bfbachmann/Terminator-2.0/progress_report/sensors_bb.png

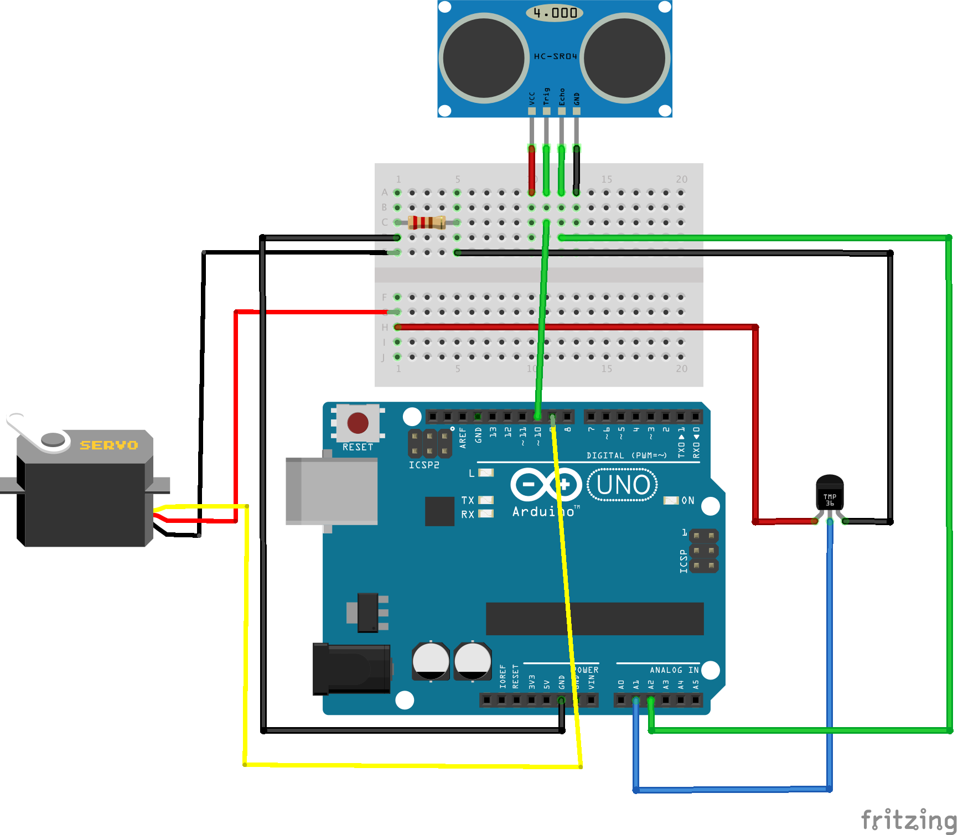
progress_report/sensors_bb.png
