bfbachmann/Terminator-2.0/report/project-1-report/line_following_block_diagram.pdf

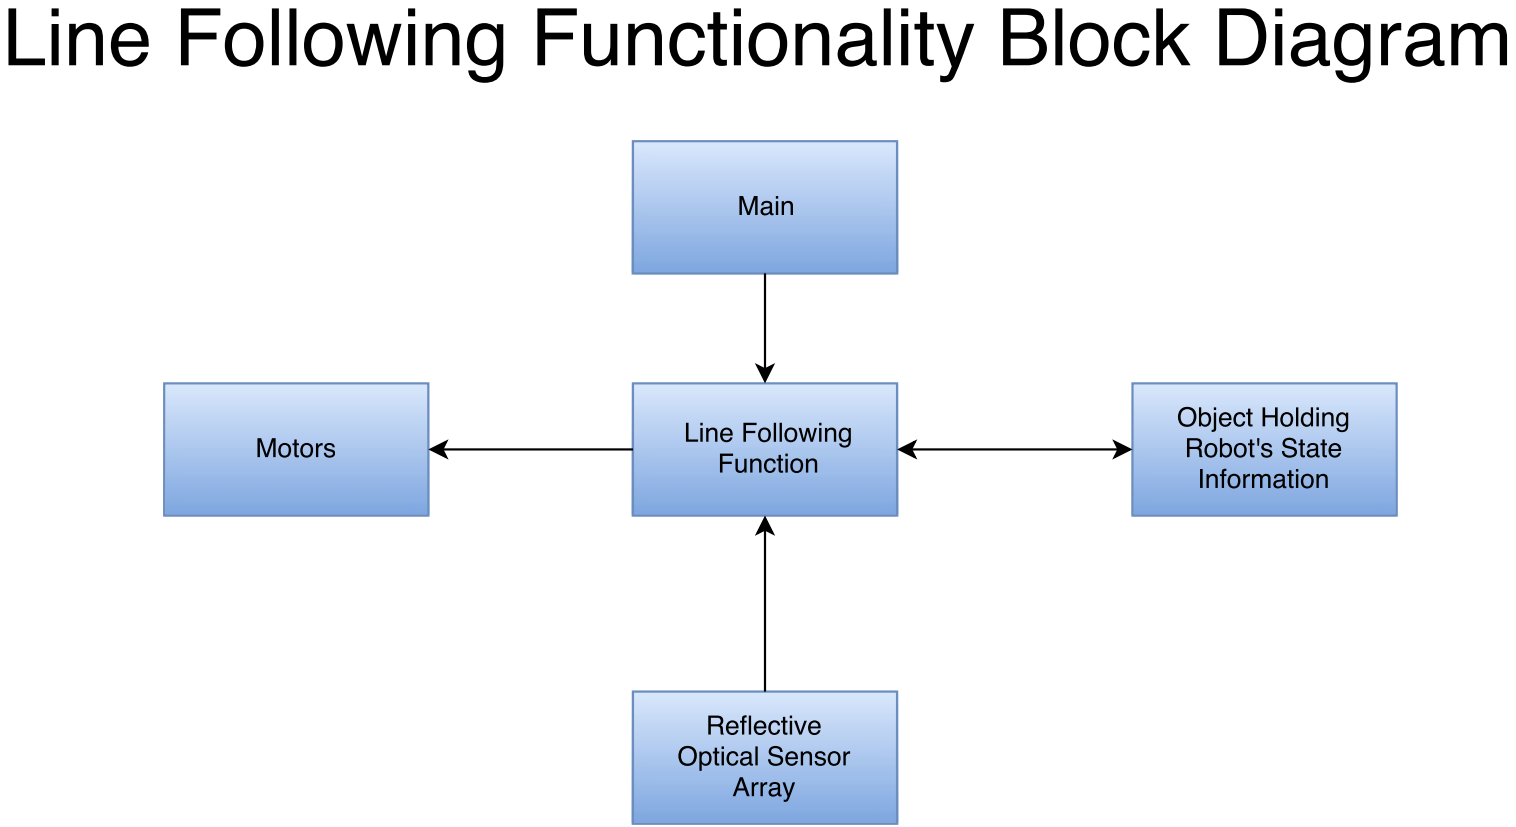
[picture p7: page 1]
