bfbachmann/Terminator-2.0/(list of files, drawings)

Other design files:
progress_report/audio.fzz
progress_report/extranfunc.fzz
progress_report/sensors.fzz
report/BRUNO sensor_and_pushbutton.fzz
report/robot.fzz
