bfbachmann/Terminator-2.0/(commit log)

2016-02-12 Added specifications for go(velocity), and for Vector typedef.
2016-02-12 added draft code for distance sensor - rory
2016-02-14 control framework started
2016-02-14 Several control tests ran. PID requires tuning, but in every quadrant, robot reaches destination. Changed go function specification, read API for details.
2016-02-17 Added temperature and distance private methods and created the ExternalData class
2016-02-24 hall effect speed sensor
2016-02-26 Further debugged Arduino code
2016-02-26 calibrated hall effect sensor code
2016-02-26 calibrated hall effect sensor and progress report
2016-02-27 added sersors fritzing file
    [sensors.fzz]
2016-02-29 Added a method to external data for getting the mode the robot is currently in from a push button. Debugged problems with writing to the servo motor in control. Modified Robot.h accordingly.
    [AI.ino, Control.ino, ExternalData.ino, Robot.h, Robot.ino]
2016-03-01 integrated line follow with object oriented framework
2016-03-01 refectored pin declarations
2016-03-02 Refactored, debugged, changed temperature to be read from slave
2016-03-03 removed PID constants - no longer in use
    [Control.ino]
2016-03-03 configured ExternalData to read from slave Arduino
2016-03-03 wheel distance tracker
2016-03-03 fixed some print statements and changed Ai.decide to use the new sweep function:
    [AI.ino, Control.ino, ExternalData.ino, Robot.h, Robot.ino]
2016-03-04 fixed bug in new sweep
    [AI.ino, Control.ino, Robot.ino]
2016-03-04 added led/mic code, added two necessary libraries - adafruit neopixel and tmrpcm
2016-03-04 go and adjustHeading slightly changed. Fixed logic in AI, refreshed batteries, updated calibration factors
    [AI.ino, Control.ino, ExternalData.ino, Robot.h]
2016-03-05 created final_report folder
    [audio.fzz, extranfunc.fzz, sensors.fzz]
2016-03-08 added my .tex file and .fzz schematic to the report folder
    [BRUNO sensor_and_pushbutton.fzz]
2016-03-09 assembly & power section written
2016-03-09 added robot fritzing schematic
    [robot.fzz]
